alexam3r/Smart.Home.Hall/PRD.md

# Project: Smart Corridor ("Argon" Refactoring)

## 1. Контекст и Цель проекта
Мы проводим глубокий архитектурный рефакторинг уже работающей монолитной прошивки для устройства «Умный коридор» (кодовое имя итерации: **Argon**). 
Исходный код текущей рабочей версии лежит в `docs/main.cpp`. Аппаратная часть полностью собрана, спаяна и **не менялась**. Текущий функционал и логика работы полностью устраивают, но код нужно переписать с нуля: разбить на независимые модули (ООП/классы), вынести чувствительные данные, повысить стабильность и устранить баг с подвисанием анимации света.

Разработка ведется строго по методологии **obra/superpowers** с поддержкой графа архитектуры через **graphify**.

---

## 2. Аппаратная платформа (Hardware Stack — без изменений)
*   **MCU:** Wemos D1 Mini (ESP8266).
*   **Питание:** БП 24В -> DC-DC XL4015 (5В для питания Wemos) + стабилизатор L7812 (12В для питания драйвера мосфета).
*   **Свет (ШИМ):** 24В LED-лента (122Вт). Управление: Пин **D7** -> неинвертирующий драйвер **TC4420** -> MOSFET **IRFZ48**. Логика прямая (0 = выкл, 1023 = макс).
*   **Теплый пол:** Твердотельное реле SSR-40 DA (600Вт) через транзистор BS170. Управление: Пин **D8**.
*   **Датчик пола:** DS18B20 (1-Wire). Пин **D5**.
*   **Датчик климата:** AM2320 (I2C). Пины **D1** (SCL), **D2** (SDA).
*   **Датчик движения:** Стандартный PIR. Пин **D6**.

---

## 3. Программные требования и Архитектура (Что меняем)

### 3.1. Модульность и Безопасность
1.  **Декомпозиция:** Разбить монолит `docs/main.cpp` на логические модули в `src/` и `include/` (например: `Config`, `Secrets`, `NetworkManager`, `LightController`, `FloorThermostat`, `SensorManager`, `Telemetry`).
2.  **Безопасность (`Secrets.h`):** Никаких паролей в коде! Вынести `WIFI_SSID`, `WIFI_PASS`, `MQTT_USER`, `MQTT_PASS` в `include/Secrets.h` (добавить его в `.gitignore` и создать шаблон `include/Secrets.h.example`).
3.  **Сеть и MQTT:** 
    *   IP-адрес брокера Mosquitto берется автоматически из DHCP как адрес шлюза по умолчанию: `WiFi.gatewayIP()`.
    *   ID клиента жестко зафиксировать (или использовать как префикс): `flowers-esp32`.
    *   Watchdog: реконнект при обрыве связи, аппаратный ребут `ESP.restart()` при отсутствии связи более 5 минут.

### 3.2. Известная проблема (БАГ ДЛЯ ИССЛЕДОВАНИЯ)
*   **Симптом:** Текущая прошивка иногда замирает («подвисает») на 1–2 секунды прямо во время плавного розжига или затухания светодиодной ленты.
*   **Параметры ШИМ:** Частота **4kHz**, разрешение 10 бит (0–1023), кривая **CIE1931** (логарифмическая), время перехода **2 секунды** (100 шагов по 20 мс).
*   **Задача на Brainstorming:** Выяснить причину фризов. *Гипотезы для проверки:* 
    1. Нагрузка на программный ШИМ ESP8266 при 4kHz + вычисление тяжелой математики `pow()` с плавающей точкой каждые 20 мс (возможно, стоит заменить `pow()` на предрасчитанную таблицу LUT в PROGMEM).
    2. Блокирующий опрос датчика DS18B20 (~750 мс) или чтение шины I2C (AM2320), или реконнект/публикация MQTT попадают ровно в тайминг работы фейдера света и блокируют `loop()`.

---

## 4. Бизнес-логика и «Грабли» (Сохранить из `docs/main.cpp`!)

1.  **Безопасный старт:** При подаче питания всё (свет, пол, режимы авто-движения) находится в `OFF`. При первом подключении к MQTT контроллер единожды публикует во все `*_state` топики статус `OFF` и дефолтную уставку пола `30.0` в `home/hall/floor/targetTemp` (с retain). Первые 10 секунд после старта PIR-датчик игнорируется (прогрев).
2.  **Раздельные таймеры бездействия:** 
    *   Два независимых таймера: `lastLightMoveTime` и `lastFloorMoveTime`.
    *   Физическое срабатывание PIR сбрасывает **ОБА** таймера и шлет `ON`/`OFF` по фронтам в `home/hall/light/move`.
    *   MQTT-команды света сбрасывают **только** таймер света. MQTT-команды пола сбрасывают **только** таймер пола.
    *   *Важно:* Сохранить защиту от `unsigned long underflow` при сравнении `millis()` и времени таймера!
3.  **Логика Света:**
    *   Топики: `home/hall/light/light` (`ON`/`OFF`), `home/hall/light/brightness` (`1`..`100`), `home/hall/light/moveDetection` (`ON`/`OFF`).
    *   Реверсивность ШИМ: Если во время розжига/затухания пришла обратная команда — плавно разворачиваемся с текущей точки яркости.
    *   **Мгновенный статус:** `home/hall/light/light_state` публикуется **мгновенно** при получении команды/триггера, НЕ дожидаясь окончания 2-секундного ШИМ! А `brightness_state` — по окончании перехода.
    *   **Ловушка Home Assistant:** Сбрасывать внутреннюю переменную яркости в `100%` **ТОЛЬКО в момент выключения (`OFF`)**. При команде `ON` использовать текущее значение (т.к. HA при движении ползунка сначала шлет `brightness`, а следом `ON`).
    *   Таймауты (проверяются всегда, когда свет горит): если `light/moveDetection == ON` -> автовыключение через **1 минуту**; если `OFF` -> через **1 час** (защита от забывчивости).
4.  **Логика Теплого пола:**
    *   Топики: `home/hall/floor/floor` (`ON`/`OFF` — мастер), `home/hall/floor/moveDetection` (`ON`/`OFF`), `home/hall/floor/targetTemp` (float, именно camelCase!).
    *   Статусы: `floor_state` (мастер, retain) и `floor_heat_state` (физическое реле SSR, retain — публиковать только при реальном переключении!).
    *   Гистерезис: **±0.5°C** от `targetTemp`. Мгновенный пересчет реле при приходе команд в топики пола.
    *   Если `floor/moveDetection == ON` и сработал PIR -> мастер `floor_state` сам переходит в `ON`.
    *   Таймауты: если `floor/moveDetection == ON` -> выключение мастера и реле через **1 час** без движения; если `OFF` -> через **12 часов** (защита).
5.  **Датчики и Телеметрия:**
    *   Опрос AM2320 и DS18B20 каждые 15 секунд (отдельные топики температуры/влажности НЕ публикуем, всё идет в телеметрию).
    *   Публикация JSON каждые 10 секунд в `home/hall/state` (retain=false).
    *   **Строгий порядок ключей JSON** (важно для парсера Node-RED/MySQL):
        `light_state`, `light_move_state`, `floor_state`, `floor_move_state`, `floor_heat_state`, `floor_temp`, `air_temp`, `air_hum`, `pir_raw`, `since_move_s` (таймер света в сек), `uptime`, `heap`. (Ошибки датчиков `-127`, `85` или `NaN` отдавать как `null`).

---

## 5. Правила работы (Workflow: Superpowers + Graphify + Git)

Мы работаем строго итеративно. **НЕ ПИШИ весь код сразу!**

1.  **Шаг 1: Анализ и Brainstorming (`obra/superpowers:brainstorming`)**
    *   Прочитай исходник в `docs/main.cpp`.
    *   Проанализируй проблему 1–2 секундных зависаний при розжиге света и предложи техническое решение.
    *   Задай мне все уточняющие вопросы по архитектуре, если что-то из ТЗ неоднозначно.
2.  **Шаг 2: Планирование (`obra/superpowers:write-plans`)**
    *   После моих ответов составь детальный поэтапный план рефакторинга, разбитый на логические блоки (Блок 1: Инфраструктура, `platformio.ini`, `Secrets.h` и базовая структура; Блок 2: Датчики и устранение блокировок; Блок 3: Модуль света и LUT CIE1931; Блок 4: Модуль пола; Блок 5: Сеть, MQTT и Телеметрия).
3.  **Шаг 3: Поэтапная реализация и Контроль (Граф + Git)**
    *   На старте создай первичную карту проекта с помощью **graphify**.
    *   После завершения **КАЖДОГО** блока из плана ты обязан:
        1. Проверить компиляцию (`pio run`).
        2. Обновить архитектурный граф проекта через **graphify**.
        3. Сделать коммит и пуш в Git (с осмысленным сообщением).
        4. **СДЕЛАТЬ ПАУЗУ** и отчитаться мне о выполненном блоке, ожидая моей команды на переход к следующему этапу.

Начинай с **Шага 1 (Изучение `docs/main.cpp` и Brainstorming)**. Жду твой анализ проблемы с подвисанием ШИМ и вопросы по проекту!

---

## 6. Уточнения, принятые по ходу рефакторинга

Эти пункты уточняют и заменяют соответствующие формулировки выше.

1. **Сброс таймеров.** Любая MQTT-команда зоны сбрасывает таймер этой зоны, включая `home/hall/light/brightness` (таймер света) и `home/hall/floor/targetTemp` (таймер пола). Срабатывание PIR по-прежнему сбрасывает оба таймера.
2. **MQTT client ID.** Фиксированный `ESP8266_Smart_Hall` (вместо `flowers-esp32`).
3. **Ошибка датчика пола.** Значение `0 °C` считать ошибкой (наравне с `-127` и `85`) и публиковать в телеметрии как `null`: помещение жилое, температура не опускается ниже 18 °C.
4. **Reconnect.** Попытки подключения к Wi-Fi/MQTT — не чаще одного раза в 5 секунд; аппаратный ребут при отсутствии связи более 5 минут сохраняется.
5. **Периодичность опроса.** DS18B20 — раз в 30 секунд (вместо 15), AM2320 — раз в 15 секунд. Чтение DS18B20 асинхронное: запрос, ожидание готовности по таймеру, затем чтение; `loop()` при этом не блокируется.
6. **Пол по команде.** Команды пола пересчитывают реле по последнему валидному измерению; принудительное чтение датчика не выполняется. Если валидных данных нет дольше 90 секунд, нагрев выключается (fail-safe).
7. **Фейдер.** Прогресс считается по прошедшему времени (номинал 2 с, обновление каждые 20 мс); визуальная плавность важнее строгого числа шагов.
8. **AM2320.** Один обмен (чтение регистра) на цикл опроса; отдельный неблокирующий драйвер не делаем, пока не появятся пропуски показаний.
