alexam3r/Smart.Home.Hall/docs/freeze-analysis.md

# Зависания анимации на 1–2 с: анализ причин

**Этап:** Argon, шаг 1 (анализ и brainstorming).
**Дата:** 2026-10-20.
**Обновление 2026-10-20:** после рефакторинга прошивка испытана на железе; зависаний не наблюдалось.

**Метод:** статический разбор `docs/main.cpp` и исходников используемых библиотек. Анализ выполнялся до подключения платы; после рефакторинга прошивка испытана на железе — см. [`hardware-test-report.md`](hardware-test-report.md).

## 1. Краткий вывод

Корневая причина — **блокирующие операции с датчиками в основном цикле**, а не математика ШИМ и не `pow()`.

1. `sensors.requestTemperatures()` ждёт окончания преобразования DS18B20 — до **750 мс** при 12-битном разрешении. Вызывается каждые 15 с, а также из MQTT-callback на каждую команду пола и при PIR-автовключении пола.
2. `am2320.readTemperature()` и `readHumidity()` — это две отдельные транзакции, каждая с `delay(10)`, `delay(2)` и до трёх повторов с `delay(100)`. В норме ~13 мс на чтение, при NACK — до ~300 мс на чтение, то есть до ~600 мс на цикл.

В худшем случае 750 + 600 ≈ **1,35 с** за одну итерацию `loop()`. Если команда пола или PIR-автовключение совпали с 15-секундным тиком, `updateFloorLogic()` успевает выполниться дважды — это ещё +750 мс, итого до ~2,1 с. Это ровно наблюдаемый диапазон 1–2 с: шаг фейдера выполняется только после возврата в `loop()`, поэтому анимация замирает, а затем продолжается с того же места.

## 2. Что именно блокирует `loop()`

| Строки `docs/main.cpp` | Операция | Оценка блокировки | Когда выполняется |
|---|---|---|---|
| 136 | `sensors.requestTemperatures()` | до **750 мс** (12 бит) | каждые 15 с (стр. 365–373); на каждую команду пола (215, 221, 226); при PIR-автовключении пола (328) |
| 369–370 | `am2320.readTemperature()` + `readHumidity()` | ~26 мс в норме; до **~600 мс** при NACK | каждые 15 с |
| 404 | `client.publish()` телеметрии | до 5 с при переполнении TCP-буфера | каждые 10 с |
| 233–256 | `client.connect()` в `reconnect()` | до 5 с на TCP-connect | при обрыве MQTT |

Источники цифр:

- **DallasTemperature 3.11.0** (разрешена `^3.9.1`): `waitForConversion = true` по умолчанию; `requestTemperatures()` вызывает `blockTillConversionComplete()`, который крутит `while (!isConversionComplete() && (millis() - start < 750)) yield();` (`MAX_CONVERSION_TIMEOUT = 750`). `yield()` отдаёт управление Wi-Fi-стеку, но **не возвращает управление в `loop()`** — приложение стоит.
- **Adafruit AM2320 1.2.5** (разрешена `^1.2.2`): и `readTemperature()`, и `readHumidity()` вызывают `readRegister32()`; внутри — `delay(10)` после пробуждения, `delay(2)` после команды и до трёх попыток с `delay(100)` при отсутствии ACK. Оба значения лежат в одном регистре, поэтому вторая транзакция избыточна.
- **ESP8266 core 3.3.0**: `analogWrite()` реализован через TIMER1/NMI-генератор волн (`core_esp8266_waveform_pwm.cpp`), а не через программный цикл. При 4 кГц и 1023 шагах это ~8 тыс. прерываний в секунду и порядка 1–2 % CPU — на паузу в секунду это не тянет.
- **WiFiClient**: `_timeout = 5000` мс по умолчанию; столько может длиться `connect()` и блокирующая запись в TCP при переполненном буфере.

## 3. Как это выглядит во времени

```text
t = 15.000 c  loop()
              am2320.readTemperature()       ~13 мс
              am2320.readHumidity()          ~13 мс
              updateFloorLogic():
                requestTemperatures()       ~750 мс   <-- анимация стоит
                getTempCByIndex(0)           ~1 мс
              ...
              один шаг фейдера (20 мс)      -> движение продолжается
```

Фейдер не «догоняет» пропущенное время: после блокировки выполняется ровно один шаг и `lastFadeTime = currentNow`, поэтому визуально это пауза, а не ускорение.

Если в этой же итерации сработал callback пола (или PIR-автовключение), `requestTemperatures()` вызовется дважды: ~1,5 с только на DS18B20, плюс AM2320.

## 4. Почему «иногда» и почему во время розжига

- Тик датчиков раз в 15 с имеет хорошие шансы совпасть с 2-секундным переходом.
- Любая команда пола (`floor/floor`, `floor/moveDetection`, `floor/targetTemp`) вызывает `updateFloorLogic()` прямо из MQTT-callback, то есть 750-мс блокировка происходит в момент прихода команды — в том числе посреди фейда.
- Если команда пола пришла в ту же итерацию, что и 15-секундный тик, чтение DS18B20 выполняется дважды подряд (~1,5 с).
- PIR при `floor/moveDetection == ON` также вызывает `updateFloorLogic()` (стр. 328).
- Home Assistant может часто присылать `targetTemp` при движении ползунка — каждый такой пакет даёт отдельный фриз.

## 5. Проверка гипотез из PRD

| Гипотеза | Вердикт | Почему |
|---|---|---|
| 1. Тяжёлый `pow()` каждые 20 мс | **Не причина 1–2 с** | 100 вызовов за 2 с даже при 1 мс на вызов дают ~100 мс, размазанных по всему переходу, а не непрерывный стопор. LUT всё равно нужен — для предсказуемости и экономии CPU. |
| 1. Программный ШИМ 4 кГц | **Не причина** | В core 3.3.0 ШИМ вынесен в NMI-генератор; цикл не участвует. |
| 2. Блокирующий DS18B20 | **Подтверждается** | 750 мс ожидания в `requestTemperatures()`. |
| 2. Блокирующий I²C AM2320 | **Подтверждается частично** | 26 мс в норме, но до ~600 мс при сбоях шины/датчика. |
| 2. MQTT-реконнект/публикация | **Вторичный фактор** | Таймауты до 5 с при недоступном брокере или переполненном TCP-буфере. |

## 6. Целевое решение (эскиз, не финальный план)

1. **DS18B20 — асинхронно, раз в 30 с.** `sensors.setWaitForConversion(false)`; конечный автомат: `requestTemperatures()` → запомнить `millis()` → через 850 мс (750 по даташиту + запас) `getTempCByIndex(0)`. Запрос сам по себе занимает ~1 мс, ожидание — без блокировки. Интервал опроса увеличен с 15 до 30 с.
2. **AM2320 — один обмен на цикл.** Читать оба значения из одного регистра (одна транзакция вместо двух); пробуждение выполняет сам драйвер (отдельный ACK-чек до пробуждения ненадёжен — спящий датчик может не ответить). Свой неблокирующий драйвер пока не делаем: пропусков показаний не наблюдалось; вернуться к этому, если появятся `null`.
3. **`FloorThermostat` не делает I/O.** Команды пересчитывают реле по последнему **валидному** измерению; обновление датчика идёт своим темпом. Гистерезис ±0.5 °C от этого не страдает — температура пола меняется медленно. При устаревших или недостоверных данных нагрев выключается (fail-safe).
4. **Фейдер — по времени.** Прогресс считать от `millis()` (номинал те же 2 с), а не инкрементом шага: пропущенный тик тогда не «замораживает» анимацию, а догоняет её. Кривая CIE1931 — таблица 101 значения в `PROGMEM`.
5. **Сеть.** Реконнект не чаще раза в 5 с (уже зафиксировано), без чтения датчиков из callback; публикации статусов — из `loop()`.
6. **Бюджет.** Цель — максимальная итерация `loop()` < 20 мс, типичная — единицы миллисекунд.

Ожидаемый эффект: сенсорный тик перестаёт быть блокирующим, максимум остаётся ~12 мс на AM2320 (если оставить библиотеку) или единицы миллисекунд (свой драйвер).

## 7. Как подтвердить на железе

Перед реализацией стоит снять логи с временными метками (патч временный, в репозиторий не коммитить):

```cpp
uint32_t t = micros();
sensors.requestTemperatures();
Serial.printf("[PERF] ds18b20=%lu us\n", micros() - t);

t = micros();
airTemp = am2320.readTemperature();
airHum  = am2320.readHumidity();
Serial.printf("[PERF] am2320=%lu us\n", micros() - t);
```

Ожидаемая картина: всплески ~750 000 мкс на DS18B20 каждые 15 с и ~25 000 мкс на AM2320; при неисправном AM2320 — до ~600 000 мкс. Если всплески совпадают с фризами — причина подтверждена. Если фризы остаются без всплесков — смотреть MQTT (`client.connect`, `publish`) и Wi-Fi.

## 8. Вопросы, влияющие на реализацию

1. **Температура пола при команде.** Сейчас команда пола делает свежее 750-мс чтение. Предлагаю переключать реле по последнему измерению (не старше 15 с) и обновлять его асинхронно. Устраивает?
2. **AM2320.** Бывают ли в телеметрии `null` по `air_temp`/`air_hum`? Если да — путь с тремя `delay(100)` реально срабатывает, и нужен свой неблокирующий драйвер; если нет — можно ограничиться одним чтением регистра на цикл (~12 мс).
3. **DS18B20.** Питание трёхпроводное или паразитное? Влияет на тайминги и надёжность асинхронного чтения.
4. **Фейдер.** Допустим ли времязависимый прогресс (те же 2 с, но с «догоном» после пропущенного тика)? Или важна строго пошаговая анимация 100 × 20 мс?
5. **Логи.** Можете снять serial-лог с метками времени (или разрешить прошить временно инструментированную легаси-версию)? Это единственное, чего не хватает для 100 % подтверждения.
6. **graphify.** В окружении не найден. Установить (подскажите пакет/репозиторий) или на первом этапе заменить картой модулей в `docs/`?

## 9. Решения владельца (2026-10-20)

| Вопрос | Решение |
|---|---|
| 1. Температура пола при команде | Да: реле по последнему валидному замеру, обновление асинхронно; при отсутствии валидных данных дольше 90 с нагрев выключается. |
| 2. AM2320 | Пропусков не замечали. Один `readRegister32` на цикл 15 с; свой драйвер не делаем, пока не появятся `null`. |
| 3. DS18B20 | Трёхпроводное питание. |
| 4. Фейдер | Времязависимый; визуальная плавность важнее строгого числа шагов. Опрос DS18B20 — раз в 30 с. |
| 5. Логи | Снять при первой прошивке; до этого — статический анализ. |
| 6. graphify | Установлен, первичный граф — в `graphify-out/`. |
