alexam3r/Smart.Home.Hall/docs/hardware-test-report.md

# Испытания на железе

**Дата:** 2026-10-20
**Устройство:** Wemos D1 Mini (ESP8266), «Умный коридор», собранный стенд.
**Прошивка:** модульная версия Argon (ветка `main`), 42 native-тестов.
**Результат:** все проверенные сценарии в норме, замечаний при испытании нет.

## Проверено

- Безопасный старт: свет и пол выключены, первые 10 секунд PIR игнорируется.
- Первое подключение к MQTT: публикация `*_state` = OFF, `brightness_state` = 100, `targetTemp` = 30.0.
- Свет: плавный розжиг и затухание 2 с, реверс с текущей точки, включение по движению.
- Свет: команда яркости доводит ШИМ ровно до заданного значения; сброс яркости в 100 при выключении.
- Свет: таймауты 1 мин / 1 ч, сброс таймера командами и PIR.
- Пол: гистерезис ±0.5 °C, ручной и автоматический режим по движению, таймауты 1 ч / 12 ч.
- Пол: невалидные/устаревшие показания DS18B20 выключают нагрев; мастер-состояние сохраняется.
- Датчики: DS18B20 и AM2320 опрашиваются, значения приходят в JSON-телеметрии.
- Телеметрия `home/hall/state`: порядок ключей, `null` при ошибках, интервал 10 с.
- MQTT: команды и retain-статусы, переподключение после обрыва.
- Плавность: зависаний анимации на 1–2 секунды не наблюдалось.

## Замечания

Нет.

## Повторные испытания после правок

Проведены 2026-10-20 после финальных исправлений:

- уставка пола живёт в одном топике `home/hall/floor/targetTemp`; MQTT-петли и потока сообщений нет;
- HA `climate` показывает фактическую уставку из retained `targetTemp`;
- DS18B20 стабильно отдаёт показания, `floor_temp` в телеметрии не `null`;
- нагрев пола держит заданную температуру согласно гистерезису.

Замечаний нет.
