alexam3r/Smart.Home.Hall/(commit log)

2026-10-20 docs: README, AGENTS.md и CLAUDE.md для рефакторинга Argon
    - README: железо и пины, карта MQTT-топиков и телеметрии, тайминги,
    сборка/прошивка, структура репозитория и статус рефакторинга
    - AGENTS.md: правила для AI-агентов, источники правды, инварианты
    поведения и workflow по блокам (pio run → graphify → commit → пауза)
    - CLAUDE.md: тонкая обёртка с импортом AGENTS.md
    - легаси-прошивка перенесена в docs/main.cpp, реальные креды заменены
    з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
2026-10-20 docs: зафиксировать решения по таймерам, client ID, 0 °C и reconnect
2026-10-20 docs: анализ причин зависаний анимации на 1–2 с
    - разобраны блокирующие вызовы в loop(): DS18B20 (до 750 мс),
    AM2320 (две транзакции, до ~600 мс при NACK), MQTT-таймауты
    - показано, почему pow() и 4-кГц ШИМ не являются причиной фризов
    - предложен эскиз неблокирующего решения и план снятия логов
    - сформулированы вопросы, влияющие на реализацию
2026-10-20 docs: решения по датчикам и фейдеру, установлен graphify
    - PRD §6: DS18B20 — 30 с и асинхронно, AM2320 — 15 с одним обменом,
    команды пола по последнему валидному замеру, fail-safe 90 с
    - AGENTS/README: обновлены тайминги, инварианты и команды graphify
    - CLAUDE.md: чтение GRAPH_REPORT.md и обновление графа
    - docs/freeze-analysis.md: зафиксированы ответы владельца
    - graphify-out: первичный граф проекта (graph.json, GRAPH_REPORT.md)
    - .gitignore: кэш graphify
2026-10-20 docs: план реализации рефакторинга Argon (шаг 2)
    - 5 блоков по PRD: инфраструктура, датчики, свет, пол, сеть
    - чистая логика в src/core с native-тестами, HAL-адаптеры в src/hal
    - тесты фейдера, гистерезиса, валидации датчиков и JSON
    - после каждого блока: pio run, pio test, graphify, коммит, пауза
2026-10-20 build: native test env и конфигурационные константы
2026-10-20 feat: скелет прошивки и шаблон секретов
2026-10-20 docs: блок 1 — статус, тесты и обновлённый граф
    - README: блок 1 завершён, добавлены pio test и структура каркаса
    - AGENTS: актуальное состояние (src/main.cpp, test/, ветка refactor/argon)
    - CLAUDE: проверка включает pio test -e native
    - graphify: граф пересобран после появления кода
2026-10-20 feat(sensors): неблокирующий автомат опроса DS18B20 и AM2320
2026-10-20 feat(sensors): аппаратный адаптер и асинхронный опрос в loop
2026-10-20 fix(sensors): убрать ненадёжный ACK-чек AM2320 перед пробуждением
    [ArduinoSensors.cpp]
2026-10-20 docs: блок 2 — статус датчиков и обновлённый граф
2026-10-20 feat(light): таблица CIE1931 в PROGMEM вместо pow()
2026-10-20 feat(light): контроллер света с времязависимым фейдером
2026-10-20 feat(light): PWM-адаптер и подключение контроллера света
2026-10-20 fix(light): не трогать PWM в глобальном конструкторе
    [LightController.cpp]
2026-10-20 docs: блок 3 — свет и обновлённый граф
2026-10-20 feat(floor): термостат с гистерезисом, таймерами и fail-safe
    [FloorThermostat.cpp]
2026-10-20 feat(floor): реле SSR и интеграция термостата
2026-10-20 docs: блок 4 — тёплый пол и обновлённый граф
2026-10-20 docs: Mermaid-схема архитектуры в README
2026-10-20 feat(telemetry): JSON с фиксированным порядком ключей и null
2026-10-20 feat(net): Wi-Fi/MQTT, команды и телеметрия
2026-10-20 docs: блок 5 — сеть, телеметрия и финальный граф
2026-10-20 docs: отметить слияние рефакторинга в main
2026-10-20 docs: контекст для свежего клона и fallback Secrets
2026-10-20 fix(light,floor): плавный реверс, валидация DS18B20 и отсечка пола
    - свет: now из MQTT-callback может быть больше now в loop() — убрана
    трактовка отрицательного elapsed как завершённого фейда; main обновляет now
    - свет: реверс/яркость теперь всегда идут от текущей точки, без рывка в 0/100
    - пол: невалидное чтение DS18B20 сразу снимает valid и выключает нагрев;
    температура ниже 5 °C считается ошибкой; ожидание преобразован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
    [Config.h, FloorThermostat.cpp, LightController.cpp, SensorManager.cpp, main.cpp]
2026-10-20 docs: испытания на железе, HA-пакет и заморозка Argon
    - зафиксированы результаты испытаний 2026-10-20: замечаний нет
    - docs/hall.yaml: пакет Home Assistant приведён к JSON-телеметрии
    (air_temp, air_hum, floor_temp) и targetTemp
    - README/AGENTS/CLAUDE/план/анализ: статус «испытано», заморозка
    - graphify: граф обновлён
2026-10-20 fix(floor): принимать legacy-топик target_temp
    Уставка из старого HA-конфига уходила в home/hall/floor/target_temp,
    а прошивка слушала только targetTemp. В результате цель оставалась 30 °C,
    пол грелся до 30.5 °C (с перелётом до ~31.3 °C) и выключался.
    - подписка и обработка target_temp как legacy-алиаса targetTemp
    - обе уставки синхронизируются retained-публикацией
    - документация, HA-пакет и отчёт испытаний обновлены
    [MqttTopics.h, NetworkManager.cpp]
2026-10-20 docs: HA climate читает retained targetTemp как состояние уставки
2026-10-20 fix(mqtt): один топик targetTemp без петли
    - удалён legacy-алиас target_temp: осталась одна уставка targetTemp
    - прошивка публикует retained-значение только при реальном изменении,
    поэтому эхо брокера не запускает повторную обработку
    - команда по-прежнему сбрасывает таймер пола
    - HA climate читает targetTemp как command+state
    - документация и отчёт испытаний обновлены
    [MqttTopics.h, NetworkManager.cpp, NetworkManager.h]
2026-10-20 fix(sensors): ждать готовность DS18B20 и повторять чтение
    - SensorManager ждёт isConversionComplete() вместо фиксированной паузы
    (с таймаутом), чтобы не читать незавершённое преобразование
    - после невалидного чтения повторный запрос через 2 с, а не через 30 с
    - диагностика: число найденных DS18B20 при старте и raw-значение в [SENS]
    - 42 native-теста, включая ожидание готовности и retry
    [ArduinoSensors.cpp, SensorManager.cpp]
2026-10-20 docs: финальная проверка на железе и заморозка Argon
    - подтверждены один targetTemp без MQTT-петли и стабильный DS18B20
    - HA climate показывает retained-уставку и текущую температуру пола
    - README/AGENTS/CLAUDE/отчёт испытаний: замечаний нет, проект заморожен
    - graphify обновлён
